freeDSP/freeDSPx-ADAT-IO-x4/Photo/Testing.jpeg

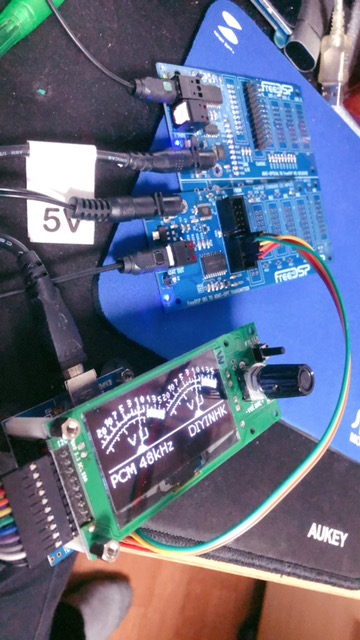
Photo/Testing.jpeg
