freeDSP/freeDSPx-ADAT-IO-x4/Photo/ADAIO_OnEvaluationSnapshot.JPG

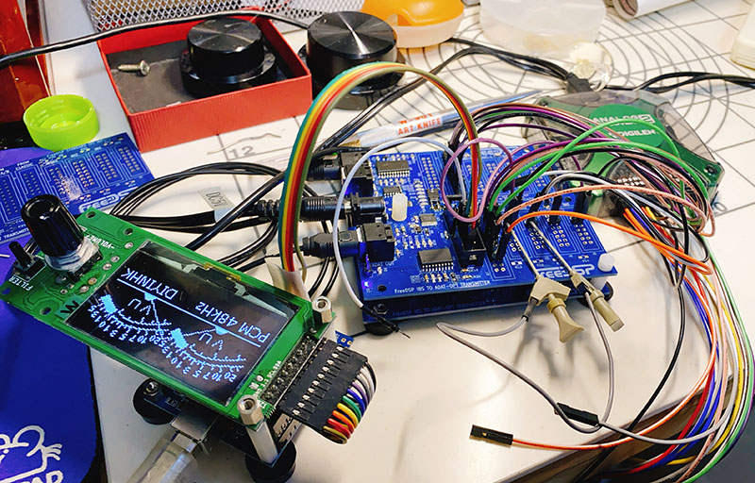
Photo/ADAIO_OnEvaluationSnapshot.JPG
