freeDSP/freeDSPx-ADAT-IO-x4/README.md

# freeDSPx-ADAT-IO-x4

BOARD STATUS: RELEASED

The freeDSPx ADAT IO x4 is a digital IO expansion board for the freeDSP family. 
It provides 4 Lightpipe(I2S) inputs and 4 Lightpipe outputs via single Toslink Cable.
48kHz sampled 8ch 23bits (23bit I8S) audio stream and 1bit Logic Signal information will transfered via single TOS-Link optical cable.
Logic I/O levels are unified 3.3V LV-CMOS level.
Optical through optput enables to connect the cascade connections such as FreeDSP --> Left Active SPK --> Right Active SPK

Enjoy!

Project web page:

(Original Japanese version) https://cyberpithilo.web.fc2.com/audio/freedsp/adat_io-x4.html

(Machine translation Yandex) 
https://translate.yandex.com/translate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

(Machine translation Google) 
https://translate.google.com/translate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

## License

This work and all other materials under https://github.com/freeDSP are licensed under a <a rel="license" href="http://creativecommons.org/licenses/by-sa/4.0/legalcode">Creative Commons Attribution Share-Alike 4.0 license</a>. This allows for both personal and commercial derivative works, as long as they credit freeDSP and release their designs under the same license.
