freeDSP/freeDSPx-ADAT-IO-x4/Photo/ADAT-IO-x4.jpg

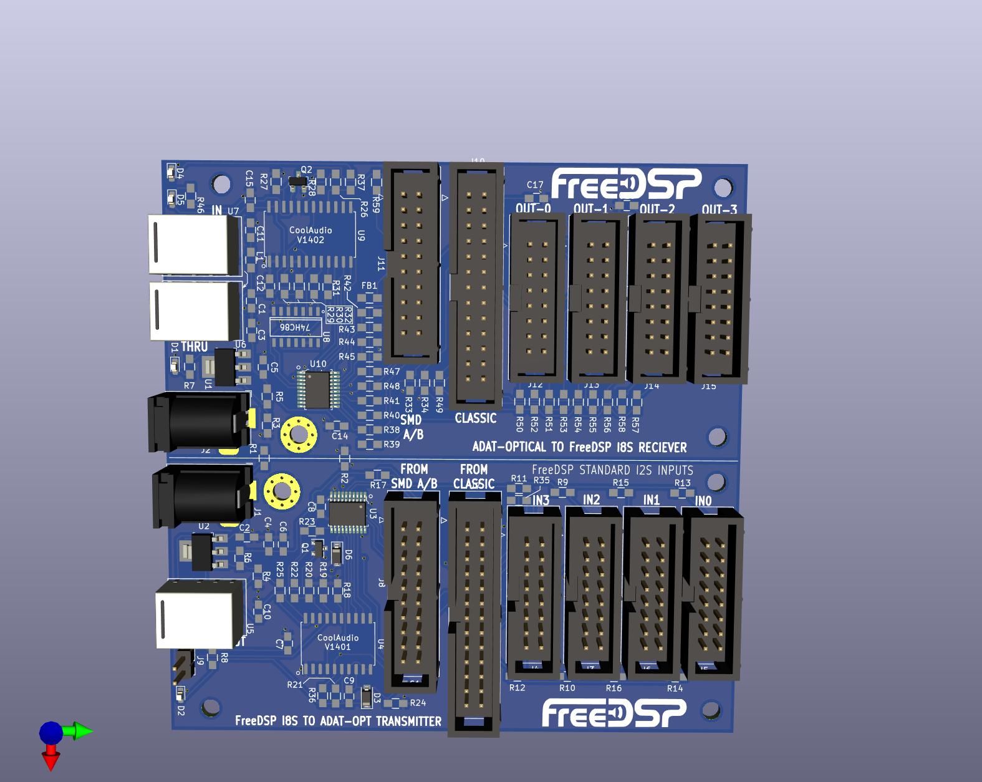
Photo/ADAT-IO-x4.jpg
