freeDSP/freeDSPx-ADAT-IO-x4/Photo/ADAT-IO-x4_BOARD.jpg

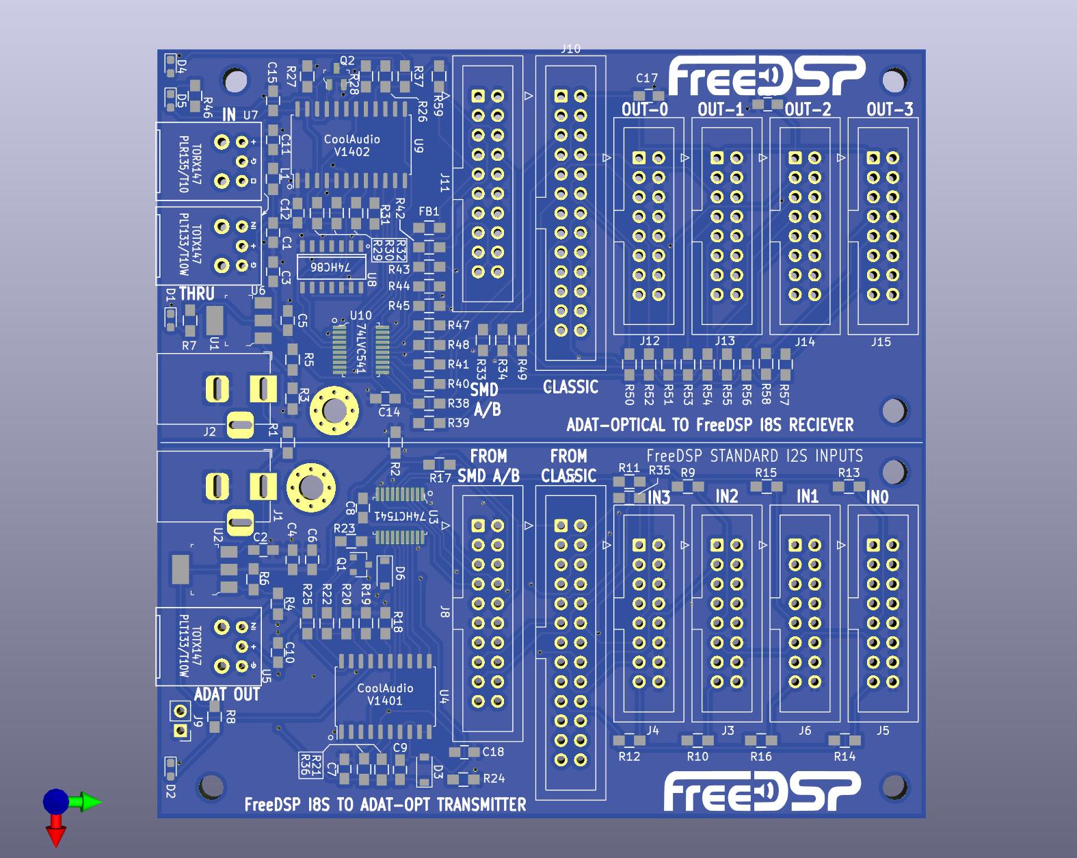
Photo/ADAT-IO-x4_BOARD.jpg
