freeDSP/freeDSPx-ADAT-IO-x4/Photo/ADAT-IO-x4_SystemBlockDiagram.png

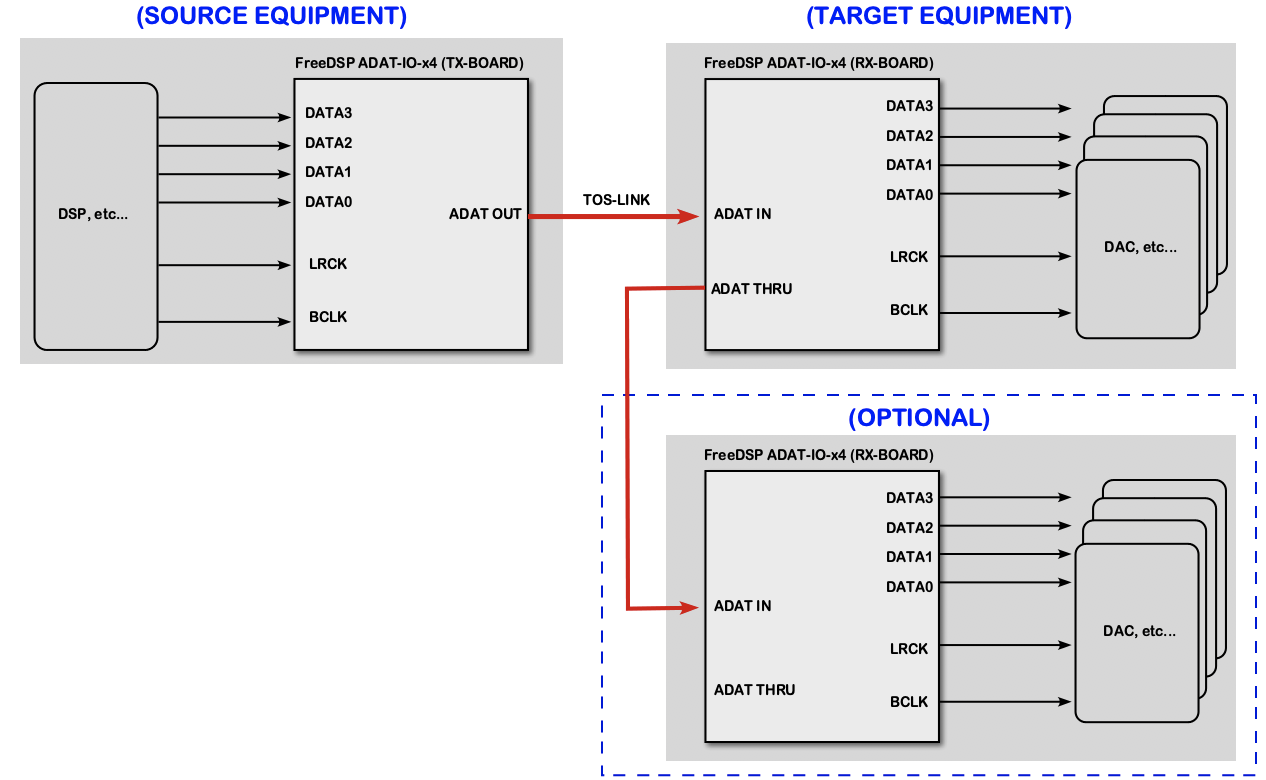
Photo/ADAT-IO-x4_SystemBlockDiagram.png
