freeDSP/freeDSPx-ADAT-IO-x4/Photo/ADATIO_I8S_Thru-Latency.gif

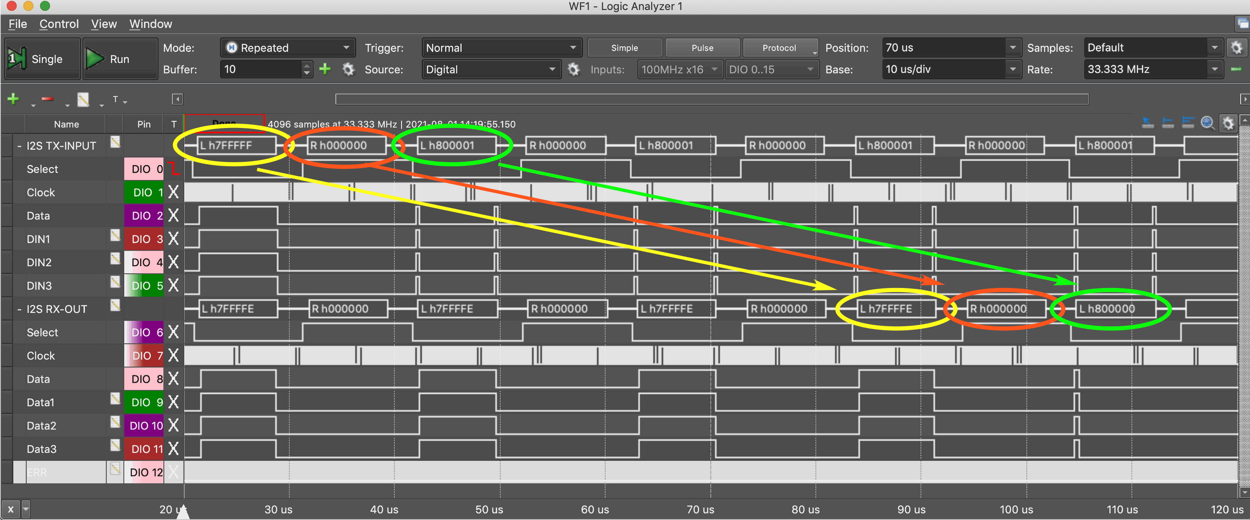
Photo/ADATIO_I8S_Thru-Latency.gif
