freeDSP/freeDSPx-ADAT-IO-x4/Photo/BareBoards_0v1.jpeg

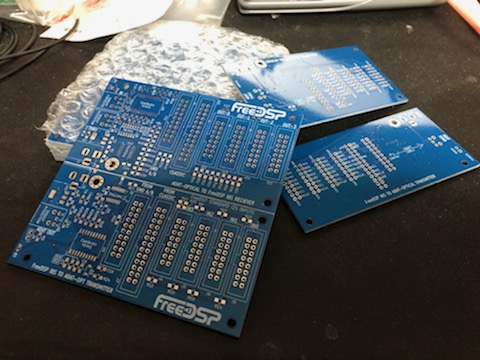
Photo/BareBoards_0v1.jpeg
