freeDSP/freeDSPx-ADAT-IO-x4/Photo/Connect_SMDAB.jpg

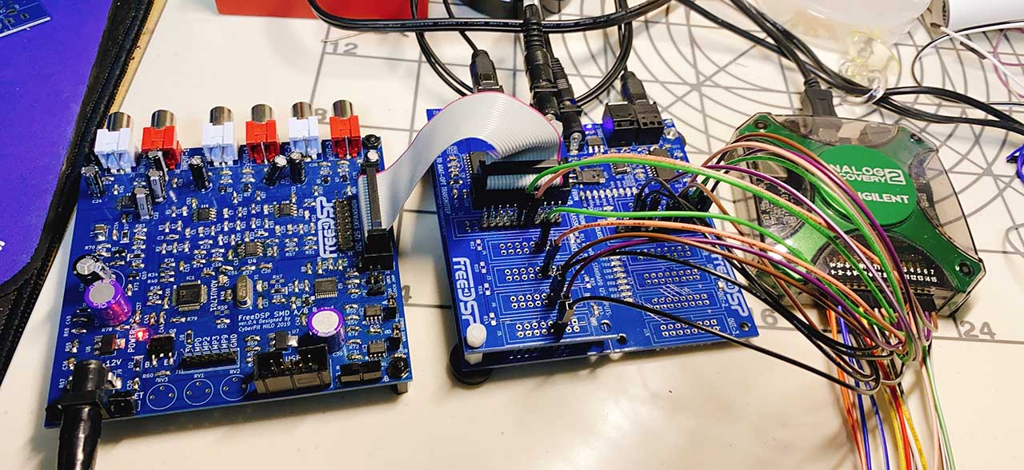
Photo/Connect_SMDAB.jpg
