freeDSP/freeDSPx-ADAT-IO-x4/Photo/MountedPCB.jpg

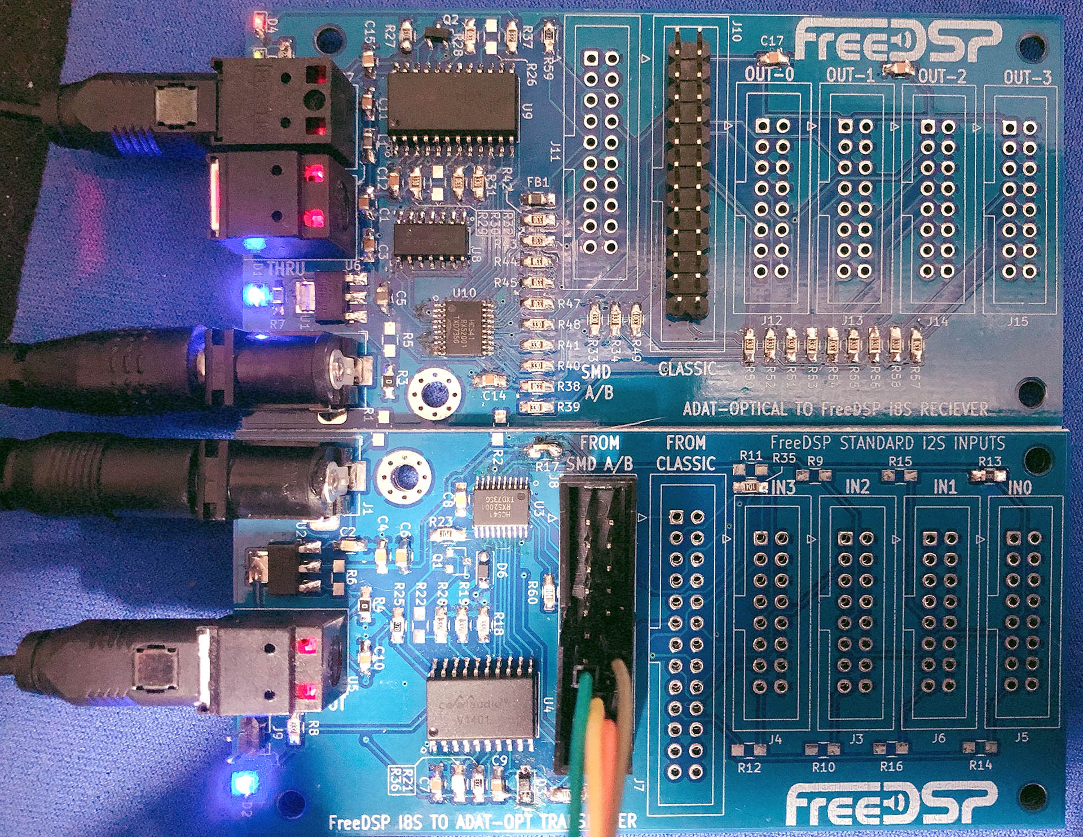
Photo/MountedPCB.jpg
