freeDSP/freeDSPx-ADAT-IO-x4/SOURCES/KICAD/ADAT-IO-x4_Schematic.pdf

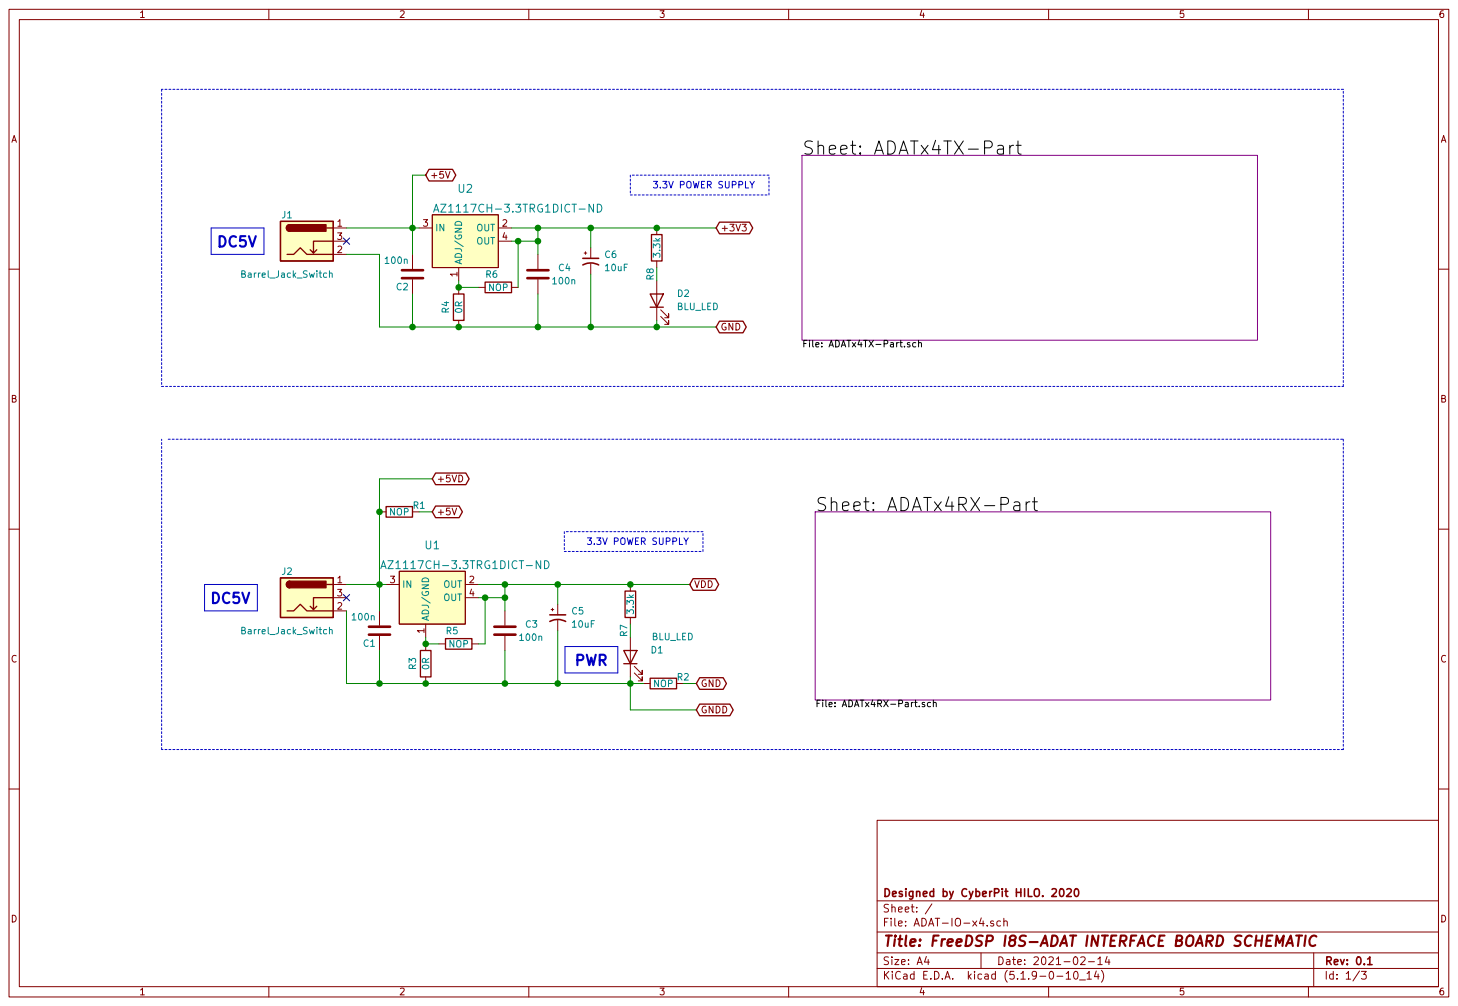
[picture p10: page 1]

Sheet: ADATx4TX-Part File: ADATx4TX-Part.sch Sheet: ADATx4RX-Part File: ADATx4RX-Part.sch ADJ/GND

File: ADAT-IO-x4.sch Sheet: / Designed by CyberPit HILO. 2020

Id: 1/3 Title: FreeDSP I8S-ADAT INTERFACE BOARD SCHEMATIC

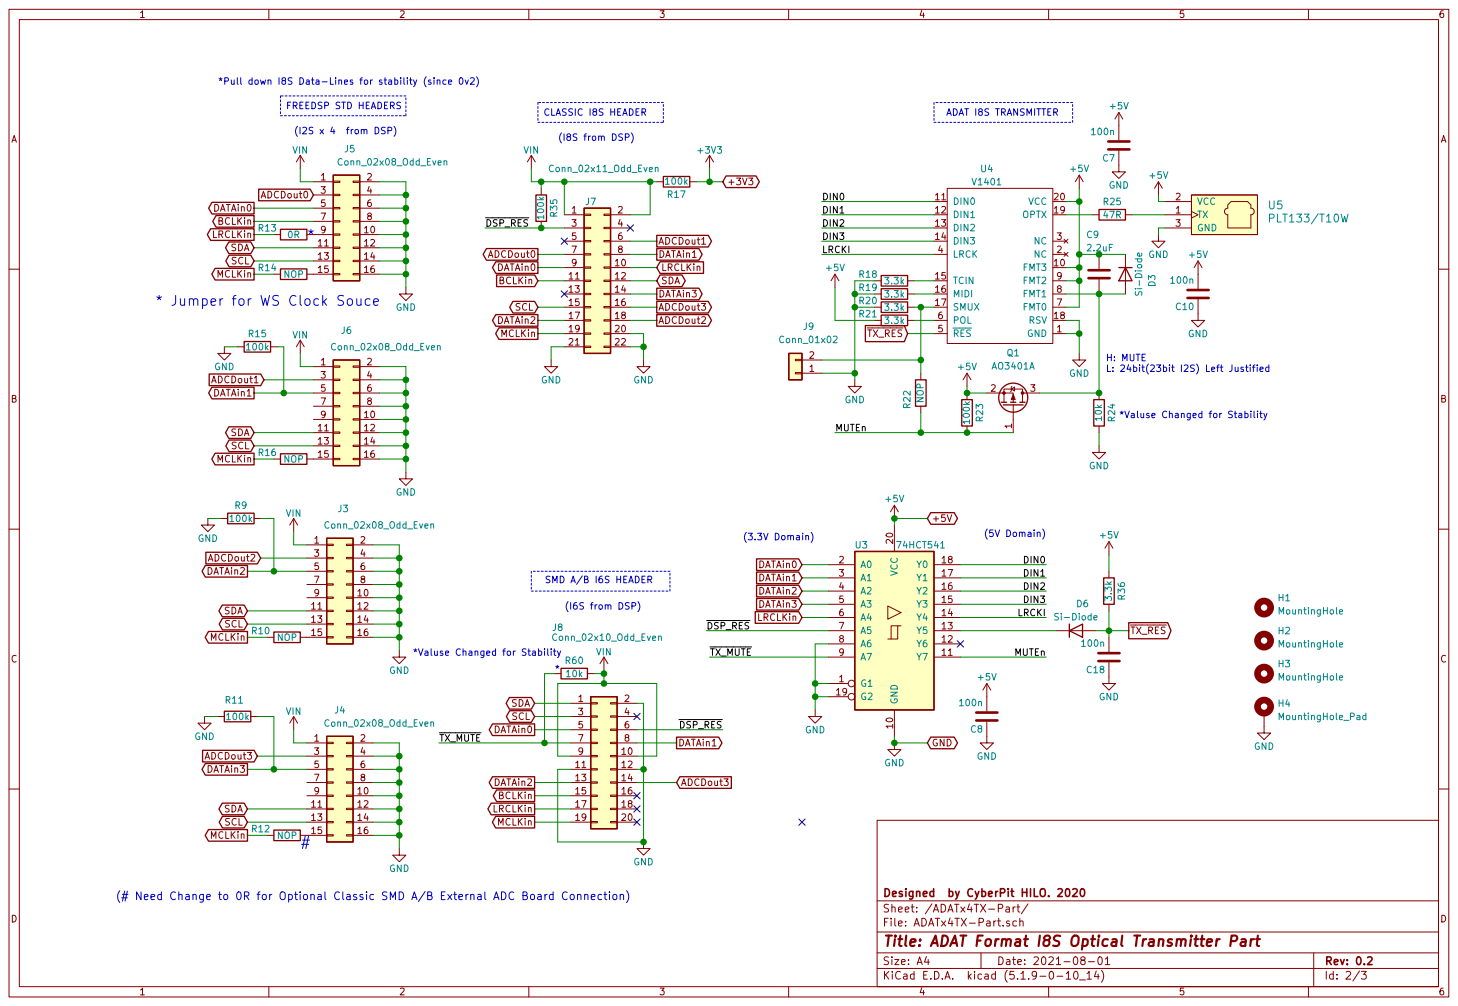
[picture p11: page 2]

*Pull down I8S Data-Lines for stability (since 0v2)
J5 Conn_02x08_Odd_Even GND
BCLKin MCLKin

* Jumper for WS Clock Souce

*Valuse Changed for Stability

GND

(# Need Change to 0R for Optional Classic SMD A/B External ADC Board Connection)

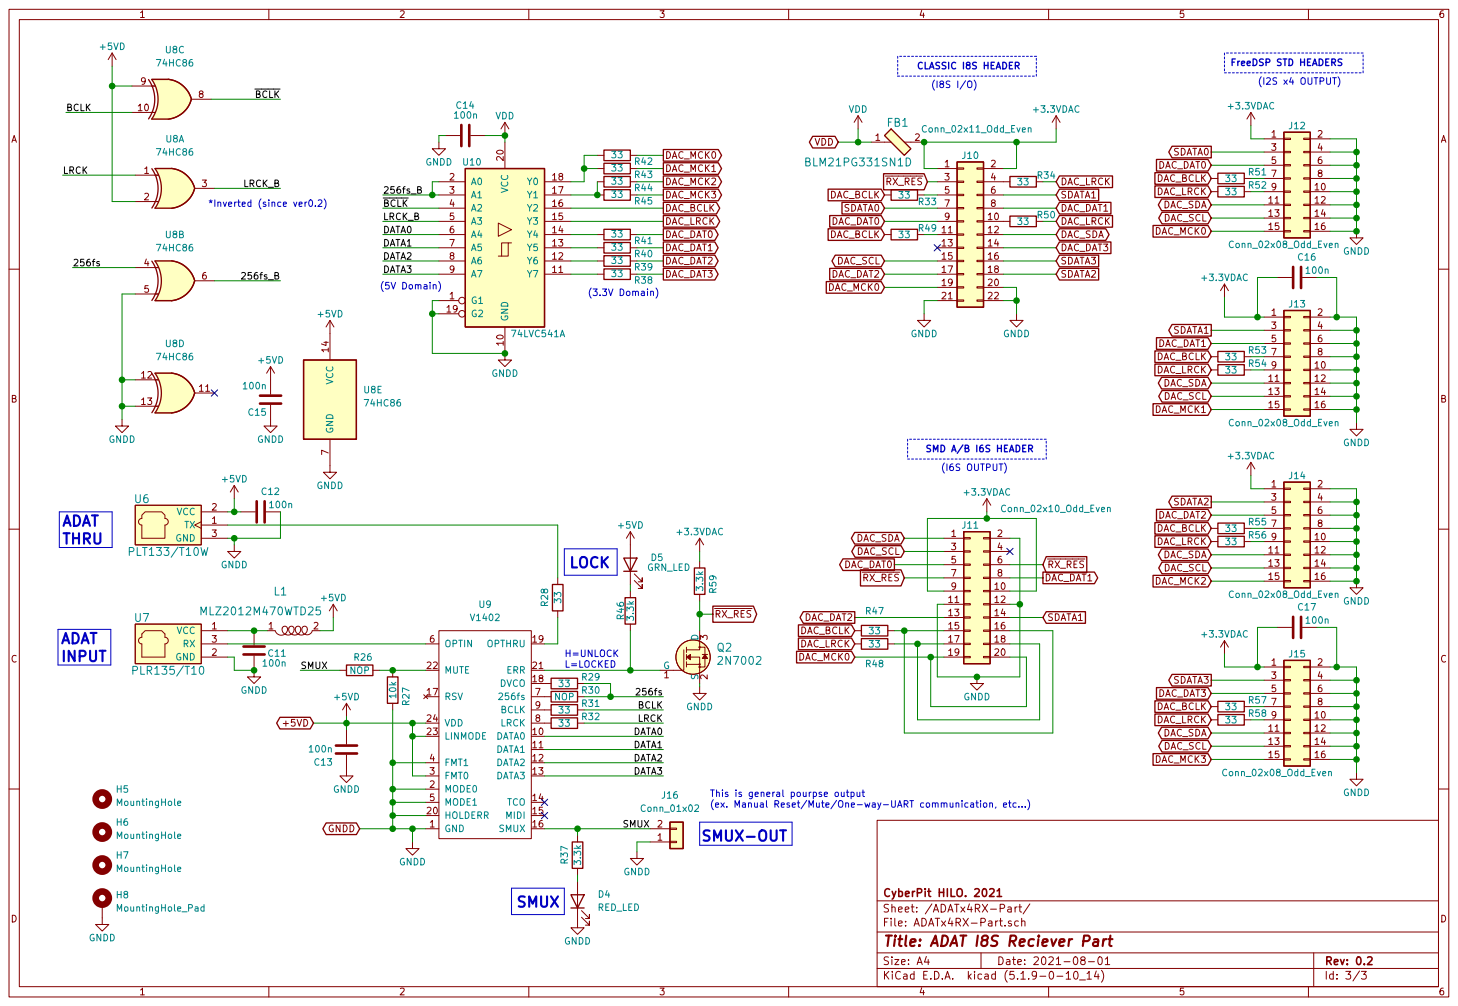
[picture p12: page 3]

GNDD GNDD

9 | 10

This is general pourpse output
(ex. Manual Reset/Mute/One-way-UART communication, etc)
SMUX-OUT
