freeDSP/freeDSPx-ADAT-IO-x4/Photo/ADAT-IO-x4.pdf

Sheet: ADATx4TX-Part File: ADATx4TX-Part.sch Sheet: ADATx4RX-Part File: ADATx4RX-Part.sch ADJ/GND

File: ADAT-IO-x4.sch Sheet: / Designed by CyberPit HILO. 2020

Id: 1/3 Title: FreeDSP I8S-ADAT INTERFACE BOARD SCHEMATIC

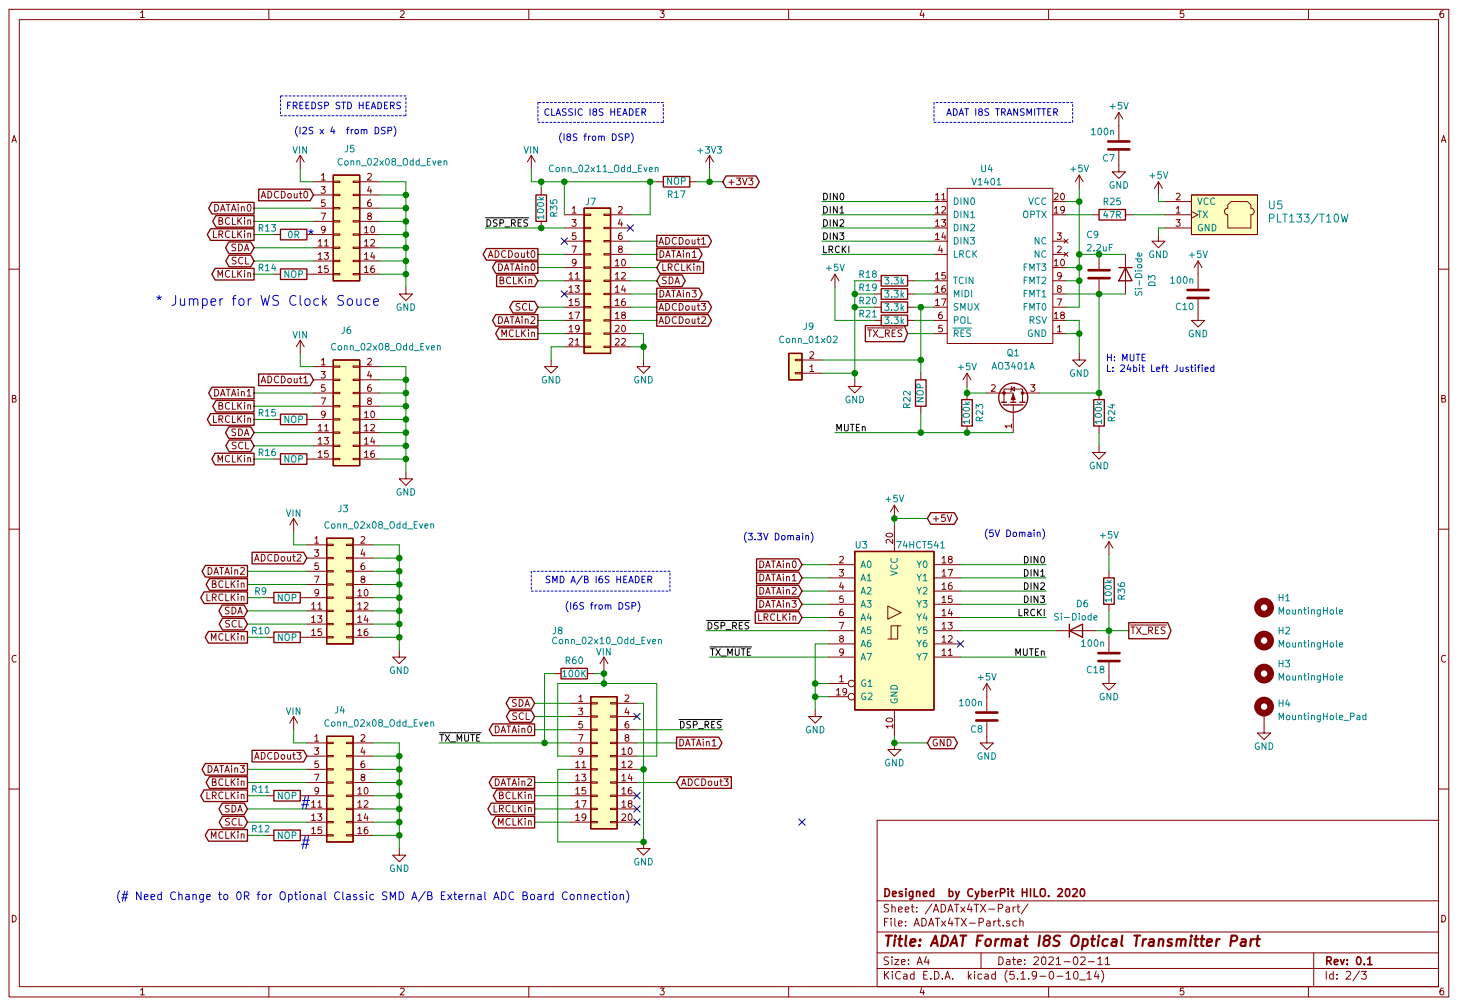
[picture p13: page 2]

ADAT I8S TRANSMITTER FREEDSP STD HEADERS
LRCLKin ADCDout0 ADCDout2 ADCDout3 ADCDout1 BCLKin BCLKin BCLKin BCLKin

SCL DATAin2 SCL MCLKin SDA
DATAin1 DATAin3

* Jumper for WS Clock Souce

(# Need Change to 0R for Optional Classic SMD A/B External ADC Board Connection)

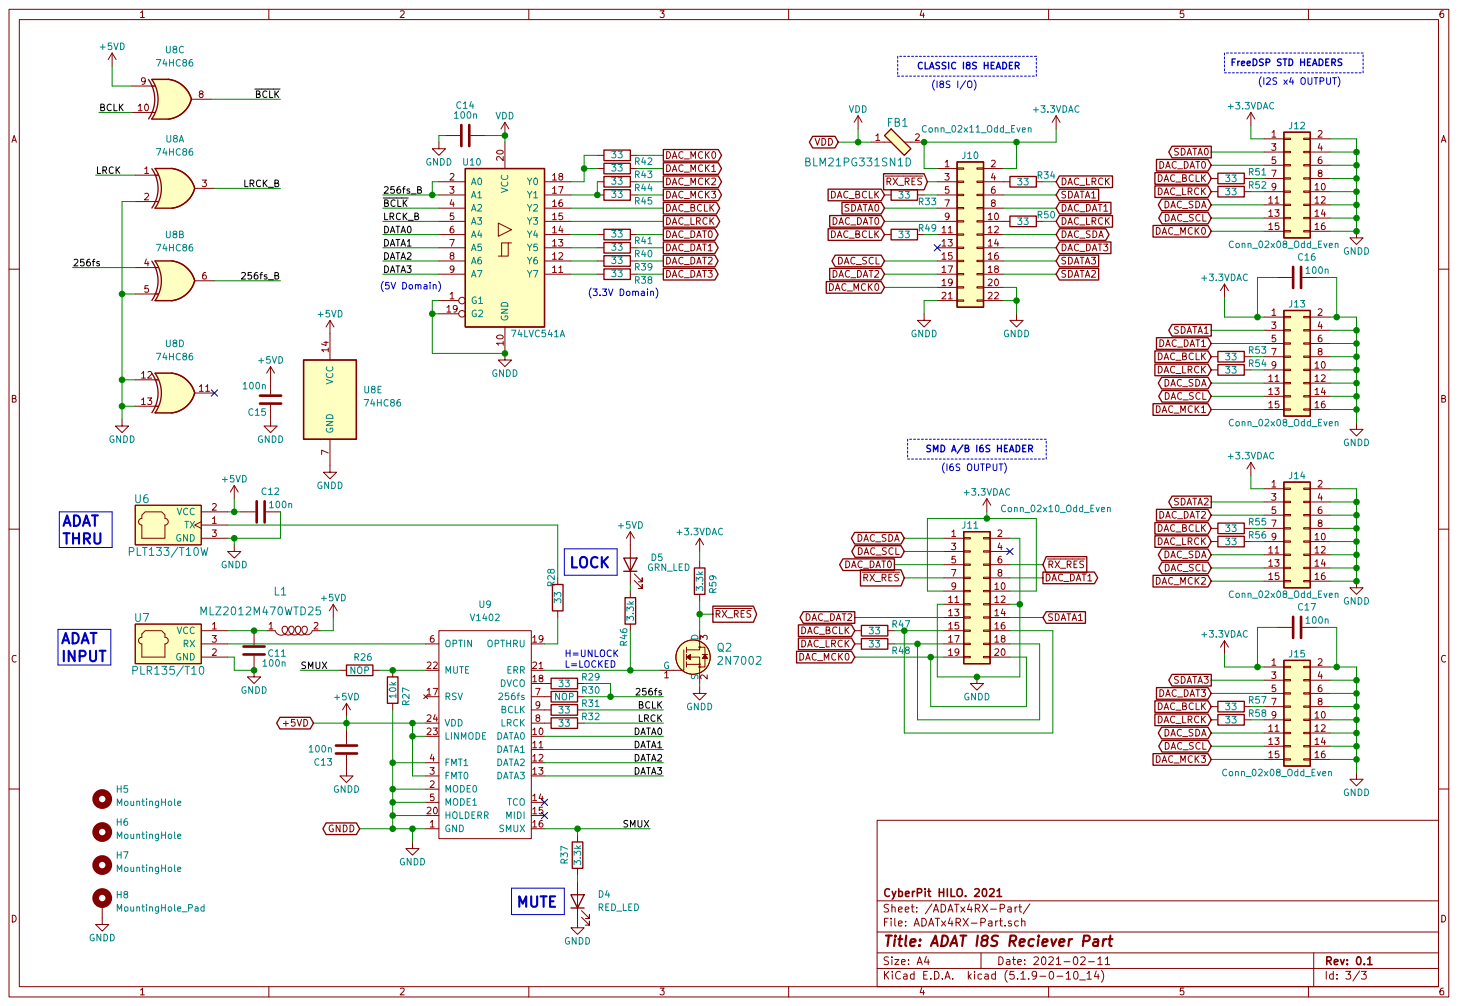
[picture p14: page 3]

9 | 10

Id: 3/3 Title: ADAT I8S Reciever Part File: ADATx4RX-Part.sch Sheet: /ADATx4RX-Part/ CyberPit HILO. 2021
