freeDSP/freeDSPx-ADAT-IO-x4/(list of files, drawings)

Other design files:
SOURCES/KICAD/ADAT-IO-x4.dsn
