freeDSP/freeDSPx-ADAT-IO-x4/SOURCES/KICAD/ADAT-IO-x4.kicad_pcb

## KiCad design SOURCES/KICAD/ADAT-IO-x4.kicad_pcb (2021-11-08)

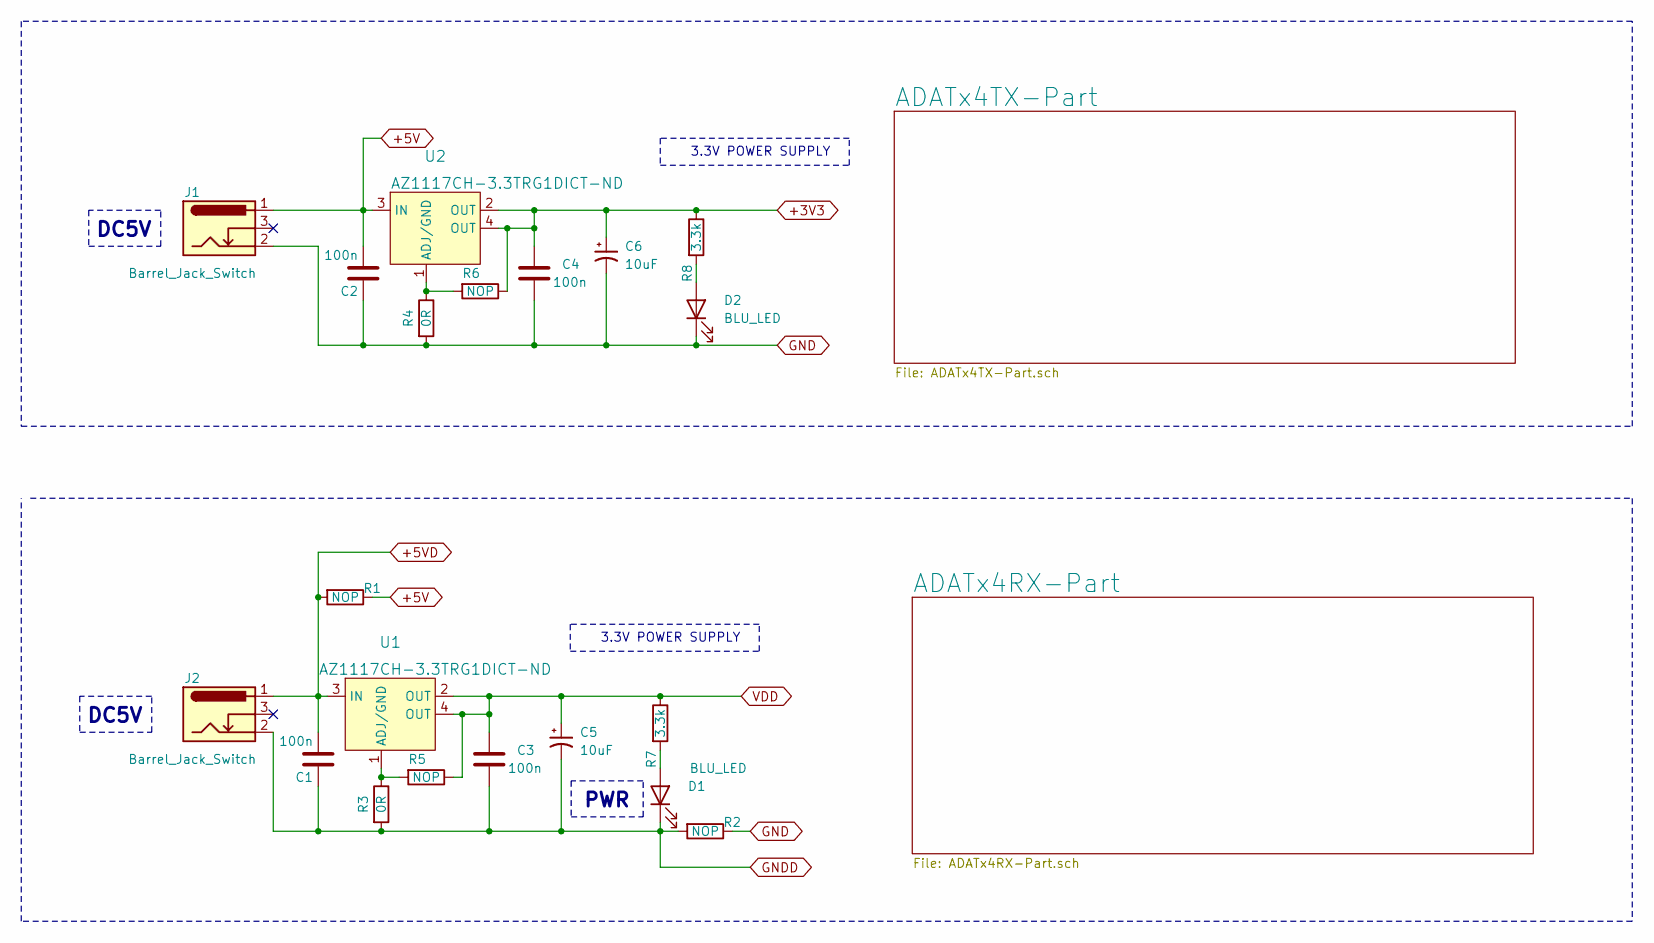
[picture p15: schematic ADAT-IO-x4.sch, FreeDSP I8S-ADAT INTERFACE BOARD SCHEMATIC]

Parts:
C1, C2, C3, C4: 100n; C_0805_HandSoldering
C5, C6: 10uF; C_0805_HandSoldering
D1, D2: BLU_LED; LED_0603_1608Metric_Pad1.05x0.95mm_HandSolder
J1, J2: Barrel_Jack_Switch; BarrelJack_Horizontal
R1, R2, R5, R6: NOP; R_0805_HandSoldering
R3, R4: 0R; R_0805_HandSoldering
R7, R8: 3.3k; R_0805_HandSoldering
U1, U2: AZ1117CH-3.3TRG1DICT-ND; SOT-223

Connections:
+3V3: C4.1, C6.1, R6.1, R8.1, U2.2 (OUT), U2.4 (OUT); also elsewhere on the board
+5V: C2.2, J1.1, R1.1, U2.3 (IN); also elsewhere on the board
+5VD: C1.2, J2.1, R1.2, U1.3 (IN); also elsewhere on the board
GND: C2.1, C4.2, C6.2, D2.1 (K), J1.2, R2.1, R4.2; also elsewhere on the board
GNDD: C1.1, C3.2, C5.2, D1.1 (K), J2.2, R2.2, R3.2; also elsewhere on the board
unnamed: D1.2 (A), R7.2
unnamed: D2.2 (A), R8.2
unnamed: R3.1, R5.2, U1.1 (ADJ/GND)
unnamed: R4.1, R6.2, U2.1 (ADJ/GND)
VDD: C3.1, C5.1, R5.1, R7.1, U1.2 (OUT), U1.4 (OUT); also elsewhere on the board

Notes on the sheet:
3.3V POWER SUPPLY
PWR
DC5V

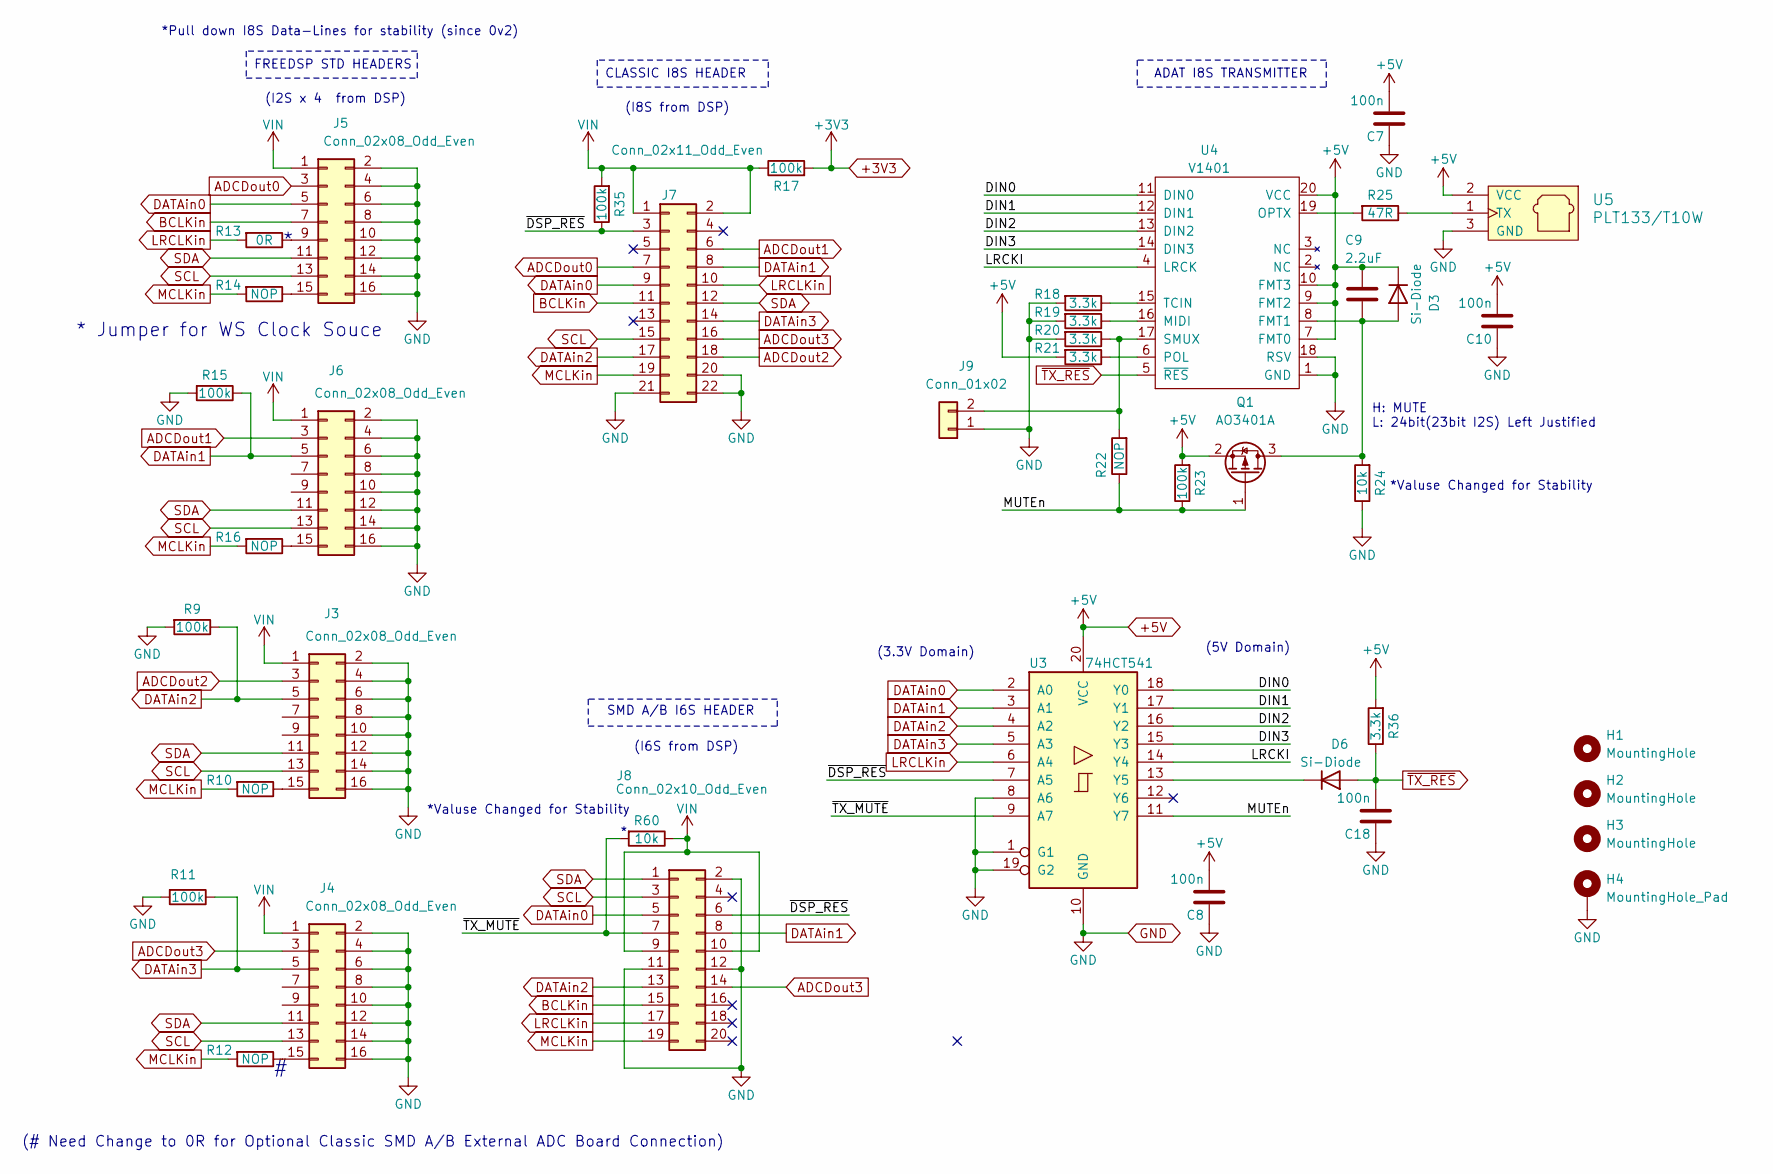
[picture p16: schematic ADATx4TX-Part.sch, ADAT Format I8S Optical Transmitter Part]

Parts:
C7, C8, C10, C18: 100n; C_0805_HandSoldering
C9: 2.2uF; C_0805_HandSoldering
D3, D6: Si-Diode; D_SOD-123
H1, H2, H3: MountingHole; MountingHole_3.2mm_M3
H4: MountingHole_Pad; MountingHole_3.2mm_M3_Pad_Via
J3, J4, J5, J6: Conn_02x08_Odd_Even; IDC-Header_2x08_P2.54mm_Vertical
J7: Conn_02x11_Odd_Even; IDC-Header_2x13_P2.54mm_Vertical
J8: Conn_02x10_Odd_Even; IDC-Header_2x10_P2.54mm_Vertical
J9: Conn_01x02; PinHeader_1x02_P2.54mm_Vertical
Q1: AO3401A; SOT-23
R9, R11, R15, R17, R23, R35: 100k; R_0805_HandSoldering
R10, R12, R14, R16, R22: NOP; R_0805_HandSoldering
R13: 0R; R_0805_HandSoldering
R18, R19, R20, R21, R36: 3.3k; R_0805_HandSoldering
R24, R60: 10k; R_0805_HandSoldering
R25: 47R; R_0805_HandSoldering
U3: 74HCT541; TSSOP-20_W4.4mm
U4: V1401; SOP-20_7.5x12.8mm_P1.27mm
U5: PLT133/T10W; PLT133-T10W

Connections:
+3V3: R17.2; also elsewhere on the board
+5V: C7.2, C8.2, C9.1, C10.2, D3.1 (K), Q1.2 (S), R21.2, R23.2, R36.2, U3.20 (VCC), U4.7 (FMT0), U4.9 (FMT2), U4.10 (FMT3), U4.20 (VCC), U5.2 (VCC); also elsewhere on the board
/ADATx4TX-Part/DIN0: U3.18 (Y0), U4.11 (DIN0)
/ADATx4TX-Part/DIN1: U3.17 (Y1), U4.12 (DIN1)
/ADATx4TX-Part/DIN2: U3.16 (Y2), U4.13 (DIN2)
/ADATx4TX-Part/DIN3: U3.15 (Y3), U4.14 (DIN3)
/ADATx4TX-Part/LRCKI: U3.14 (Y4), U4.4 (LRCK)
/ADATx4TX-Part/MUTEn: Q1.1 (G), R22.1, R23.1, U3.11 (Y7)
/ADATx4TX-Part/~DSP_RES: J7.3, J8.6, R35.1, U3.7 (A5)
/ADATx4TX-Part/~TX_MUTE: J8.7, R60.2, U3.9 (A7)
ADCDout0: J5.3, J7.7
ADCDout1: J6.3, J7.6
ADCDout2: J3.3, J7.18
ADCDout3: J4.3, J7.16, J8.14
BCLKin: J5.7, J7.11, J8.15
DATAin0: J5.5, J7.9, J8.5, U3.2 (A0)
DATAin1: J6.5, J7.8, J8.8, R15.1, U3.3 (A1)
DATAin2: J3.5, J7.17, J8.13, R9.1, U3.4 (A2)
DATAin3: J4.5, J7.14, R11.1, U3.5 (A3)
GND: C7.1, C8.1, C10.1, C18.1, H4.1, J3.2, J3.4, J3.6, J3.8, J3.10, J3.12, J3.14, J3.16, J4.2, J4.4, J4.6, J4.8, J4.10, J4.12, J4.14, J4.16, J5.2, J5.4, J5.6, J5.8, J5.10, J5.12, J5.14, J5.16, J6.2, J6.4, J6.6, J6.8, J6.10, J6.12, J6.14, J6.16, J7.20, J7.21, J7.22, J8.2, J8.11, J8.12, J9.1, R9.2, R11.2, R15.2, R18.2, R19.2, R20.2, R24.1, U3.1 (G1), U3.8 (A6), U3.10 (GND), U3.19 (G2), U4.1 (GND), U4.18 (RSV), U5.3 (GND); also elsewhere on the board
LRCLKin: J7.10, J8.17, R13.2, U3.6 (A4)
MCLKin: J7.19, J8.19, R10.2, R12.2, R14.2, R16.2
unnamed: C9.2, D3.2 (A), Q1.3 (D), R24.2, U4.8 (FMT1)
unnamed: D6.1 (K), U3.13 (Y5)
unnamed: J3.15, R10.1
unnamed: J4.15, R12.1
unnamed: J5.9, R13.1
unnamed: J5.15, R14.1
unnamed: J6.15, R16.1
unnamed: J9.2, R20.1, R22.2, U4.17 (SMUX)
unnamed: R18.1, U4.15 (TCIN)
unnamed: R19.1, U4.16 (MIDI)
unnamed: R21.1, U4.6 (POL)
unnamed: R25.1, U5.1 (TX)
unnamed: R25.2, U4.19 (OPTX)
SCL: J3.13, J4.13, J5.13, J6.13, J7.15, J8.3
SDA: J3.11, J4.11, J5.11, J6.11, J7.12, J8.1
VIN: J3.1, J4.1, J5.1, J6.1, J7.1, J7.2, J8.9, J8.10, R17.1, R35.2, R60.1
~TX_RES: C18.2, D6.2 (A), R36.1, U4.5 (~RES)

Notes on the sheet:
H: MUTE L: 24bit(23bit I2S) Left Justified
* Jumper for WS Clock Souce
FREEDSP STD HEADERS
CLASSIC I8S HEADER
SMD A/B I6S HEADER
ADAT I8S TRANSMITTER
(I6S from DSP)
(I8S from DSP)
(I2S x 4 from DSP)
(# Need Change to 0R for Optional Classic SMD A/B External ADC Board Connection)
(3.3V Domain)
(5V Domain)
*Pull down I8S Data-Lines for stability (since 0v2)
*Valuse Changed for Stability

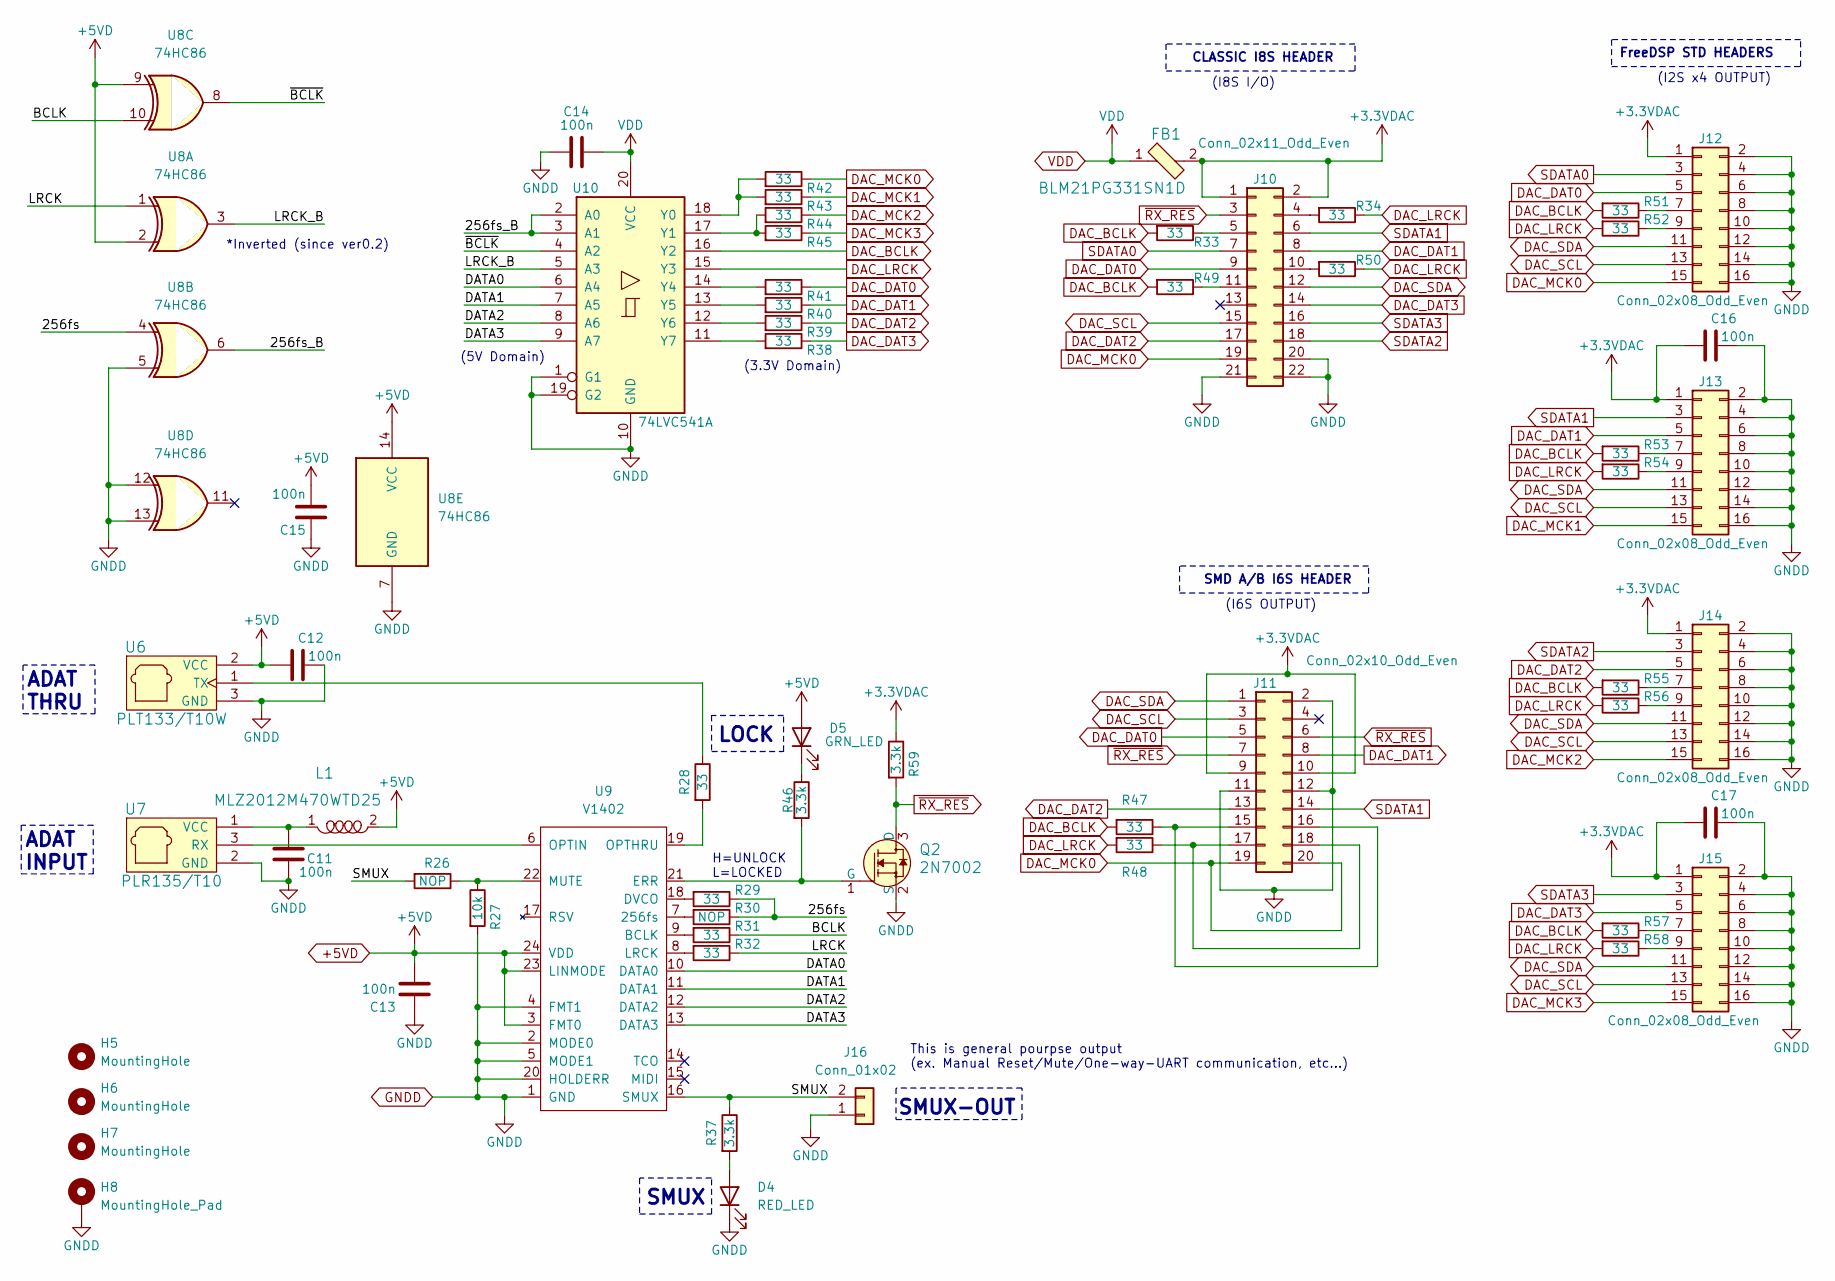
[picture p17: schematic ADATx4RX-Part.sch, ADAT I8S Reciever Part]

Parts:
C11, C12, C13, C14, C15, C16, C17: 100n; C_0805_HandSoldering
D4: RED_LED; LED_0603_1608Metric_Pad1.05x0.95mm_HandSolder
D5: GRN_LED; LED_0603_1608Metric_Pad1.05x0.95mm_HandSolder
FB1: BLM21PG331SN1D; R_0805_HandSoldering; MPN BLM21PG331SN1D; Digi-Key_PN 490-5988-1-ND
H5, H6, H7: MountingHole; MountingHole_3.2mm_M3
H8: MountingHole_Pad; MountingHole_3.2mm_M3_Pad_Via
J10: Conn_02x11_Odd_Even; IDC-Header_2x13_P2.54mm_Vertical
J11: Conn_02x10_Odd_Even; IDC-Header_2x10_P2.54mm_Vertical
J12, J13, J14, J15: Conn_02x08_Odd_Even; IDC-Header_2x08_P2.54mm_Vertical
J16: Conn_01x02; PinHeader_1x02_P2.54mm_Vertical
L1: MLZ2012M470WTD25; R_0805_HandSoldering; MPN 82103C; Digi-Key_PN 811-2473-1-ND
Q2: 2N7002; SOT-23-3; MPN 2N7002; Digi-Key_PN 2N7002NCT-ND
R26, R30: NOP; R_0805_HandSoldering
R27: 10k; R_0805_HandSoldering
R28, R29, R31, R32, R33, R34, R38, R39, R40, R41, R42, R43, R44, R45, R47, R48, R49, R50, R51, R52, R53, R54, R55, R56, R57, R58: 33; R_0805_HandSoldering
R37, R46, R59: 3.3k; R_0805_HandSoldering
U6: PLT133/T10W; PLT133-T10W
U7: PLR135/T10; PLR135-T10
U8: 74HC86; SO14_3.9x8.7mm_Pitch1.27mm
U9: V1402; SOP-24_7.5x15.4mm_P1.27mm
U10: 74LVC541A; TSSOP-20_W4.4mm

Connections:
+3.3VDAC: C16.1, C17.1, FB1.2, J10.1, J10.2, J11.9, J11.10, J12.1, J13.1, J14.1, J15.1, R59.1
+5VD: C12.1, C13.2, C15.2, D5.2 (A), L1.2, U6.2 (VCC), U8.2, U8.9, U8.14 (VCC), U9.3 (FMT0), U9.23 (LINMODE), U9.24 (VDD); also elsewhere on the board
/ADATx4RX-Part/256fs: R29.1, R30.1, U8.4
/ADATx4RX-Part/256fs_B: U8.6, U10.2 (A0), U10.3 (A1)
/ADATx4RX-Part/BCLK: R31.1, U8.10
/ADATx4RX-Part/DATA0: U9.10 (DATA0), U10.6 (A4)
/ADATx4RX-Part/DATA1: U9.11 (DATA1), U10.7 (A5)
/ADATx4RX-Part/DATA2: U9.12 (DATA2), U10.8 (A6)
/ADATx4RX-Part/DATA3: U9.13 (DATA3), U10.9 (A7)
/ADATx4RX-Part/LRCK: R32.1, U8.1
/ADATx4RX-Part/LRCK_B: U8.3, U10.5 (A3)
/ADATx4RX-Part/SMUX: J16.2, R26.2, R37.1, U9.16 (SMUX)
/ADATx4RX-Part/~BCLK: U8.8, U10.4 (A2)
DAC_BCLK: R33.2, R47.2, R49.2, R51.2, R53.2, R55.2, R57.2, U10.16 (Y2)
DAC_DAT0: J10.9, J11.5, J12.5, R41.1
DAC_DAT1: J10.8, J11.8, J13.5, R40.1
DAC_DAT2: J10.17, J11.13, J14.5, R39.1
DAC_DAT3: J10.14, J15.5, R38.1
DAC_LRCK: R34.1, R48.2, R50.1, R52.2, R54.2, R56.2, R58.2, U10.15 (Y3)
DAC_MCK0: J10.19, J11.19, J11.20, J12.15, R42.1
DAC_MCK1: J13.15, R43.1
DAC_MCK2: J14.15, R44.1
DAC_MCK3: J15.15, R45.1
DAC_SCL: J10.15, J11.3, J12.13, J13.13, J14.13, J15.13
DAC_SDA: J10.12, J11.1, J12.11, J13.11, J14.11, J15.11
GNDD: C11.1, C12.2, C13.1, C14.1, C15.1, C16.2, C17.2, D4.1 (K), H8.1, J10.20, J10.21, J10.22, J11.2, J11.11, J11.12, J12.2, J12.4, J12.6, J12.8, J12.10, J12.12, J12.14, J12.16, J13.2, J13.4, J13.6, J13.8, J13.10, J13.12, J13.14, J13.16, J14.2, J14.4, J14.6, J14.8, J14.10, J14.12, J14.14, J14.16, J15.2, J15.4, J15.6, J15.8, J15.10, J15.12, J15.14, J15.16, J16.1, Q2.2 (S), R27.2, U6.3 (GND), U7.2 (GND), U8.5, U8.7 (GND), U8.12, U8.13, U9.1 (GND), U9.2 (MODE0), U9.4 (FMT1), U9.5 (MODE1), U9.20 (HOLDERR), U10.1 (G1), U10.10 (GND), U10.19 (G2); also elsewhere on the board
unnamed: C11.2, L1.1, U7.1 (VCC)
unnamed: D4.2 (A), R37.2
unnamed: D5.1 (K), R46.1
unnamed: J10.4, R34.2
unnamed: J10.5, R33.1
unnamed: J10.10, R50.2
unnamed: J10.11, R49.1
unnamed: J11.15, J11.16, R47.1
unnamed: J11.17, J11.18, R48.1
unnamed: J12.7, R51.1
unnamed: J12.9, R52.1
unnamed: J13.7, R53.1
unnamed: J13.9, R54.1
unnamed: J14.7, R55.1
unnamed: J14.9, R56.1
unnamed: J15.7, R57.1
unnamed: J15.9, R58.1
unnamed: Q2.1 (G), R46.2, U9.21 (ERR)
unnamed: R26.1, R27.1, U9.22 (MUTE)
unnamed: R28.1, U6.1 (TX)
unnamed: R28.2, U9.19 (OPTHRU)
unnamed: R29.2, U9.18 (DVCO)
unnamed: R30.2, U9.7 (256fs)
unnamed: R31.2, U9.9 (BCLK)
unnamed: R32.2, U9.8 (LRCK)
unnamed: R38.2, U10.11 (Y7)
unnamed: R39.2, U10.12 (Y6)
unnamed: R40.2, U10.13 (Y5)
unnamed: R41.2, U10.14 (Y4)
unnamed: R42.2, R43.2, U10.18 (Y0)
unnamed: R44.2, R45.2, U10.17 (Y1)
unnamed: U7.3 (RX), U9.6 (OPTIN)
SDATA0: J10.7, J12.3
SDATA1: J10.6, J11.14, J13.3
SDATA2: J10.18, J14.3
SDATA3: J10.16, J15.3
VDD: C14.2, FB1.1, U10.20 (VCC); also elsewhere on the board
~RX_RES: J10.3, J11.6, J11.7, Q2.3 (D), R59.2

Notes on the sheet:
SMD A/B I6S HEADER
(I6S OUTPUT)
FreeDSP STD HEADERS
(I2S x4 OUTPUT)
CLASSIC I8S HEADER
(I8S I/O)
LOCK
SMUX
ADAT INPUT
ADAT THRU
H=UNLOCK L=LOCKED
(5V Domain)
(3.3V Domain)
*Inverted (since ver0.2)
SMUX-OUT
This is general pourpse output (ex. Manual Reset/Mute/One-way-UART communication, etc…)

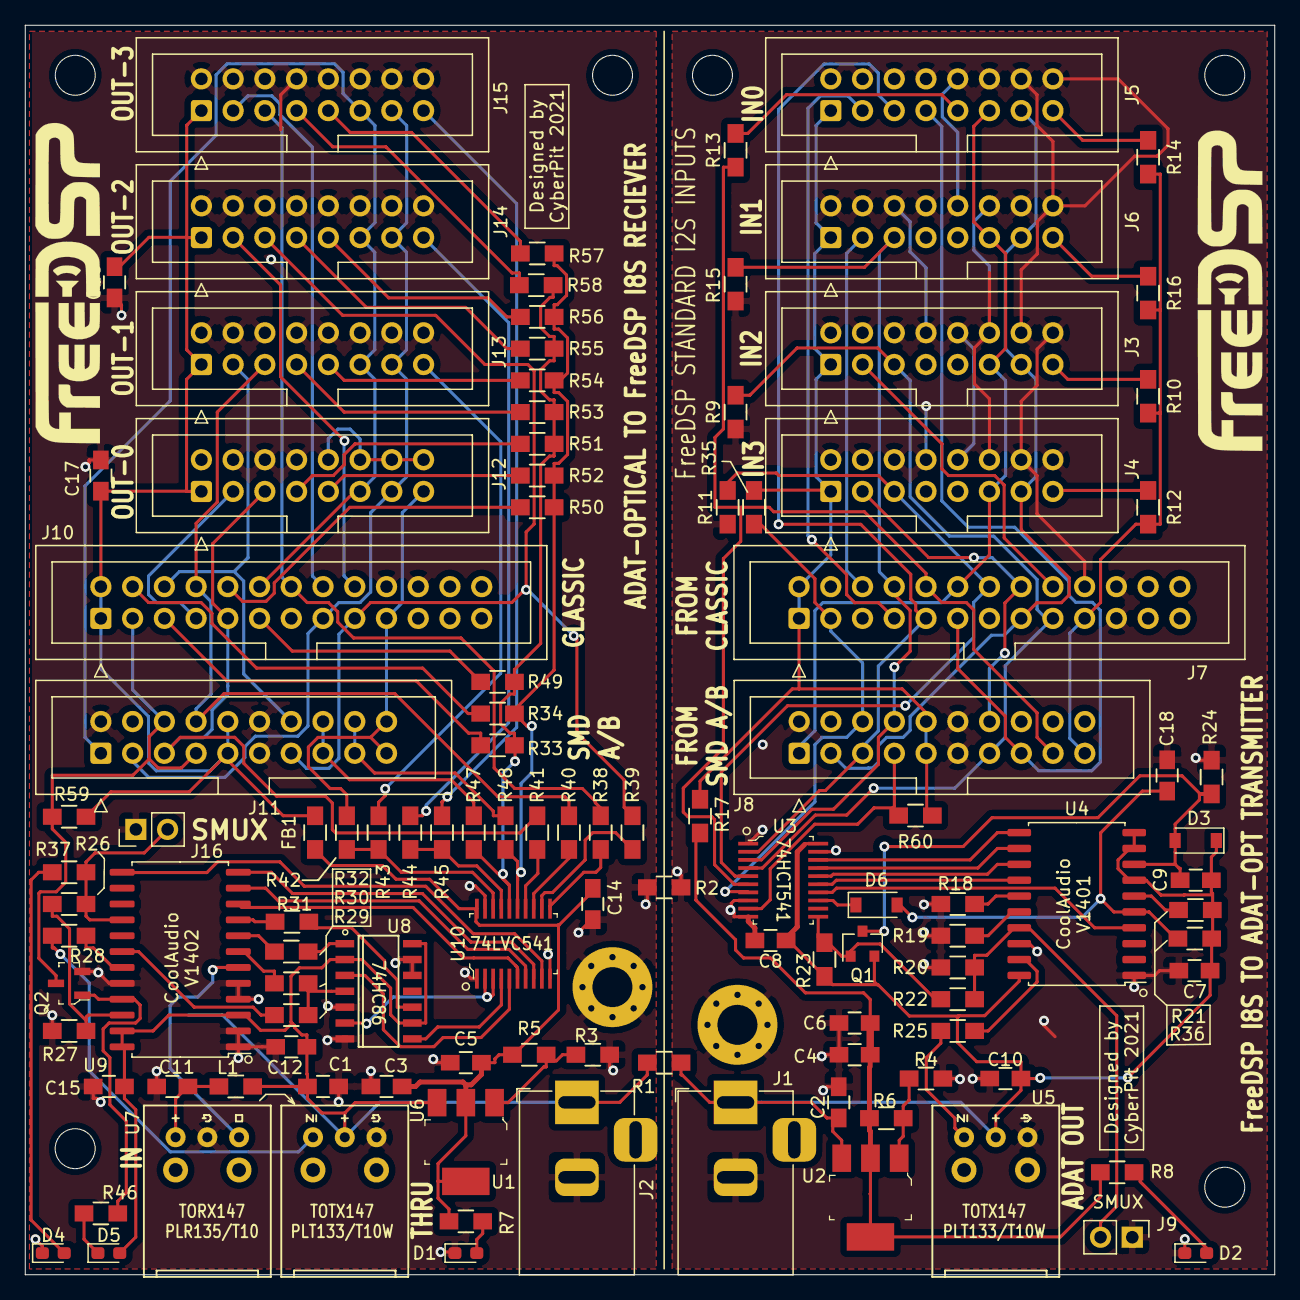
[picture p18: board ADAT-IO-x4.kicad_pcb from above]

Board: 2 copper layers, 100.0 x 100.0 mm, 122 parts (1 on the bottom side), 107 nets.
