freeDSP/freeDSPx-ADAT-IO-x4/(commit log)

2016-09-24 Xilinx project created
    [adatiox4_pad.csv]
2017-01-03 Schematic of prototype
    [ADAT-IO-x4.kicad_pcb, ADAT-IO-x4.sch, ADAT-IO-x4a.kicad_pcb]
2017-01-05 PCB layout prototype
    [ADAT-IO-x4.kicad_pcb, ADAT-IO-x4.sch]
2017-01-07 Changed Termination
    [ADAT-IO-x4.kicad_pcb, ADAT-IO-x4.sch]
2021-03-06 Yet another CoolAudio device version of ADAT-IO-x4
    [ADAT-IO-x4.dsn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]
2021-04-03 PCB had arrived.
2021-04-17 ElectricalPartsMounted PCB
2021-04-17 R36 value changed to 3k3
    [ADATx4TX-Part.sch]
2021-08-01 ADAT-IO-x4 Initial Relese ver0.2 Board Production Files
    Gerber Data
    [ADAT-IO-x4.GBL, ADAT-IO-x4.GBO, ADAT-IO-x4.GBP, ADAT-IO-x4.GBS, ADAT-IO-x4.GTL, ADAT-IO-x4.GTO, ADAT-IO-x4.GTP, ADAT-IO-x4.GTS]
2021-08-01 ADATA-IO-x4 ki-CAD Initial Release version 0.2
    [ADAT-IO-x4.kicad_pcb, ADATx4RX-Part.sch, ADATx4TX-Part.sch]
2021-08-01 Version 0.2 is an Evaluated Inital Release
    Changed points from ver 0.1
    1. RX side LRCK phase was inverted.
    2. Changed some resistance values.
    3. Added some silkscreen text notes.
